soyeon24/espcam_with_decision/(commit log)

2026-09-16 Drive the posture judgement from the ESP32-CAM stream
    The --source esp path existed but had never been attached to a board, and the
    viewer ignored the three hooks esp_source already exposed for exactly this:
    coverage, stale and send().
    Draw the coverage field, not the reconstructed distances. Distances come back
    from a mask through an apparent-size estimate, so the array holds two values
    and a palette over it is a two-colour silhouette. Coverage is what the board
    actually streams and it carries a gradient. 'v' switches to the distance array
    when you want to see what the judgement sees; 'a' toggles the contrast stretch,
    which is on by default because a difference field lives in the bottom of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
2026-09-16 Make the posture viewer the one tool: judgement plus the board's own knobs
    Three viewers meant the judgement lived in the file nobody was running. The
    tuning view got opened against the board, showed its plain black-and-white mask
    and skeleton panels, judged nothing, and looked broken.
    posture_viewer now carries viewer.py's knobs, so one window covers calibration,
    judgement and tuning. 'v' cycles the left panel through coverage, the zone
    distances the judgement actually uses, the mask and the skeleton, and the panel
    is labelled - reading the wrong layer as the judgement's input was easy before.
    Exposure and auto-exposure say what they cost: the board rebuilds its
    background under them, whic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
    [camera_source.py, esp_source.py, posture_viewer.py]
2026-09-16 Smooth the distance axis, which is the only thing separating slump from recline
    Both postures drop the head in a 2D projection, so head height only measures
    how far from the reference and the sign of the distance change decides which
    way. That makes the distance axis the one carrying the whole discrimination -
    and on a sensor with no depth it is reconstructed from apparent torso width,
    which rides on mask area and so moves with clothing contrast and lighting frame
    to frame.
    It was going into judge() as a per-frame instantaneous value. With the mask
    width jittering by a zone and a half, dist_mm came out with a 163 mm standard
    deviation against a RECLINE_SPAN_MM of 150 - the noise was larger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
    [posture.py]
2026-09-16 Recline has to be held too, or a nod takes the label off a drowsy person
    Slumping already had this guard: a nod's bottom is geometrically identical to
    folding forward, so slump only counts once it has been held SLUMP_HOLD_S. The
    same argument applies to reclining and was never made.
    A real nod takes the upper body with it. Apparent size dips while the head is
    down, the distance axis reads that as leaning away, and recline sits first in
    the label order - so the spike replaces DROWSY with RECLINE for as long as the
    head is down. Reclining is a posture somebody settles into; a nod is a
    transient, and it should not be able to reach the label at all.
    recline now scales by how long it has been h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
    [posture.py, test_posture.py]
2026-09-17 Fix two status printf calls that print the wrong values, one of them fatally
    Both status() calls had fewer conversions than arguments, so every label after
    the first carried its neighbour's value.
    vision.c was missing eff and inv, leaving 15 conversions for 17 arguments:
    open= printed the effective threshold, fill= printed invert, and so on down the
    line, with crcerr and dropped falling off the end entirely. Nothing crashed,
    but '?' is the only way to read how many frames failed CRC or were dropped, and
    it was reporting neither - while appearing to report everything.
    esp32cam_sender was missing guard, which pushed prev_every into fps_cap's %s.
    A uint8_t read as a pointer: at the default 0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
    [esp32cam_sender.ino]
2026-09-17 Stop a single em-dash from killing the tools on a Korean console
    posture_viewer died on its first print. The Windows console encodes through the
    locale code page - cp949 here - and an em-dash has no cp949 encoding, so print
    raised UnicodeEncodeError before the window ever opened. --help went the same
    way, on the module docstring.
    Two layers. The em-dashes are now hyphens, 41 of them, so the tools are plain
    cp949 throughout and output reads properly rather than as replacement marks.
    And stdout and stderr are reconfigured with errors="replace" at startup, which
    is the part that matters: the character that broke this was typographic and
    invisible in review, and on an English-locale console it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
    [camview.py, esp_source.py, posture.py, posture_viewer.py, viewer.py]
2026-09-17 Make the ESP path look like the camera path, and say when the background is stale
    The two sources are meant to be interchangeable, and they were not: the camera
    stand-in laid down a synthetic desk and wall for the zones it does not own,
    while the ESP path filled them with a single wall value. Same geometry, same
    judgement, completely different picture - a two-colour silhouette against flat
    navy instead of a body over a desk. Switching sensors should not change what
    you are looking at, so mask_to_zone now builds the same desk. It cannot move
    the judgement: background calibration takes those values as its reference, so
    the intrusion depth they produce is unchanged, and the suite agrees.
    The d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
2026-09-17 Keep status text out of the middle of a frame
    say() writes to the CDC FIFO directly rather than through out_buf, so pressing
    '?' while a frame was draining spliced the reply into it and the host lost that
    frame to a CRC failure. It showed up as a status line running into binary.
    Commands are now handled only once the buffer is empty, and say() refuses
    outright if it is not.
    cfg_open defaults to 0, matching the board this was tuned on. An opening severs
    any connection a single cell wide and at 54x42 a neck is about that, which
    detaches the head into a blob of its own for the largest-component step to
    throw away.
    [posture_log.csv]
2026-09-17 Keep run artifacts out of the repository
    A posture log and a snapshot went in with the last commit and were pushed. They
    are session output, not source, and publishing somebody's recorded posture data
    was never asked for. Removed and ignored.
    [posture_log.csv]
2026-09-17 Hold status text until a whole line fits
    say() ignored what tud_cdc_n_write returned. With frames filling the CDC FIFO
    there was often less room than the line needed, so it went out cut in half -
    seen as a status ending at skel=1 with the next frame's bytes behind it. Now the
    line waits: not truncated, not spliced into a frame, just late.
2026-09-17 Halve the nod amplitude, and show how far a nod fell short
    Drowsy took forever to register because the threshold was the size of the thing
    it was measuring. 0.10 of the baseline spread is about three rows at a typical
    0.85, and 42 rows cover the whole view, so a row is roughly 3 cm - while a
    drowsy nod drops the head 5 to 10 cm, two or three rows. Most nods sat under
    the bar, the rate never accumulated, and the label never arrived. 0.06 puts it
    at one to two rows: measured, 3-row nods now count and 2-row nods miss by 0.002.
    The panel gains that measurement. All it showed before was nod/min sitting at
    zero, which cannot distinguish a nod that was too small from no nod at all -
    there was no w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
    [posture.py, posture_viewer.py]
2026-09-17 Write the log as it goes, and say when nothing was tagged
    Two minutes of recording produced nothing usable twice over. The rows were held
    in memory and written in the finally block, so closing the window instead of
    pressing q threw all of them away; and when the tag keys never reached the
    window - OpenCV only delivers them to the focused image window, not the
    terminal - the file came out complete and entirely untagged, with nothing said
    about it either way.
    Rows now go to disk as they are produced, flushed every sixty, so an abrupt
    close keeps everything up to that point. On exit the tag counts are printed,
    and when there are none the message says so and why, because a silent
    untagged log l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
2026-09-17 Measure head width, which the chair cannot reach
    The chair reclines with the person. Captured as background in one position, it
    becomes foreground in every other, and since it is attached to the person the
    largest-component step keeps it - so the silhouette is person plus chair and
    every area measurement is contaminated.
    That breaks the axis the direction rests on. Measured on the board: leaning
    back drops occupancy to 12-14% when the chair stays put, but with the chair
    coming along it *rises* above the seated baseline. Reclining reads as growing,
    which is what folding forward is supposed to look like, and the two postures
    become the same reading. Reconstructed distance is worse still - it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
2026-09-17 Warn when the head is cut off at the top of frame
    Drowsy barely registered and the reason was not the detector. top_row sat at
    0.000 for 92% of the nodding segment: the head was against the top edge, so
    nodding moved a crop rather than a head and there was nothing to measure. Head
    height carries the deviation magnitude and nodding is that height oscillating,
    so clipping takes out both at once - and it does it silently, with the panel
    reporting plausible numbers throughout.
    Upright had two rows of clearance. Anything that brings the head nearer the
    camera spends them.
    The panel now says so when 40% of the last forty frames are clipped. It is a
    framing problem and only the person sitting the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
    [posture_viewer.py]
2026-09-17 Read direction from head width, and stop the nod baseline remembering the last posture
    Labelled recordings, finally - upright/slump/recline/drowsy, head in frame
    throughout - and they settle the direction question. Head width against the
    seated reference: upright 1.00-1.08, folding forward 1.15-1.69, leaning back
    0.46-0.92, with the fifth percentile of one and the ninety-fifth of the other
    both landing on 1.08. Reconstructed distance overlaps across the same frames.
    So recline now comes off head width, and replaying the recording takes slump
    from 61% to 86% and recline from 27% to 64%.
    Tuned on the slope rather than the label threshold. Dropping the threshold to
    0.40 read recline better but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
2026-09-17 Tune the direction axis on measured distance, and look for nodding first
    Head width was the wrong call. It separated cleanly in one setup - folding
    forward 1.15-1.69 against the seated reference, leaning back 0.46-0.92 - and
    after the camera came down it inverted: folding forward now shrank the head
    more than leaning back did. An axis whose sign depends on where the camera sits
    cannot carry the decision. Reconstructed distance kept its sign through both
    setups, so the direction goes back to it, and head width stays logged and shown
    because it is still worth seeing.
    The threshold is relative now, not millimetres. Sitting distance differs
    between setups and a fixed 40 mm deadband does not tra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
    [posture.py, test_posture.py]
2026-09-17 Timestamp the log file name
    Each run wrote posture_log.csv and overwrote the last, so recordings made under
    different camera positions could not be put side by side - and the one that
    argued for head width was gone by the time the next one contradicted it.
    --log still takes an explicit path.
2026-09-17 Stop asking a nod to last longer than the sensor can resolve
    NOD_MIN_DOWN_S was 0.30 s against frames arriving every 0.083 s, so the gate sat
    at 3.6 samples - close enough to the resolution that a real three-tenths dip can
    measure as a quarter. 0.18 still demands three consecutive frames down, which is
    what the gate is for, without depending on where the sampling happened to land.
    It changes nothing in the recording that prompted it: the same three nods survive
    either way, because the detector works off a rolling eight-second median rather
    than the segment median the offline check used, and the dips it rejects are not
    the ones that looked short. Kept because the reasoning holds on its own a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
    [posture.py]
2026-09-17 Ship the built firmware so a clone can be flashed without a toolchain
    Getting to a running system meant a Pico SDK checkout, CMake, Ninja, a host
    compiler for picotool and a PlatformIO install - about a gigabyte of downloads
    before the first frame. The binaries are 464 KB.
    Four images for the ESP32, because flashing the application alone leaves a
    partition table that does not match it, and boot_app0 comes from the Arduino
    core rather than the project build.
2026-09-17 Put the whole path from clone to judgement at the top of the README
    The first thing on the page was what the bridge is for, and the posture stage -
    the reason to run any of this - was four hundred lines down past two build
    recipes. Somebody arriving at the repository now sees the two flashes and the
    one command, with the prebuilt images linked, before any of the how.
